PimentoFr/plant-monitor/hardware/schema/plant_monitor.pdf

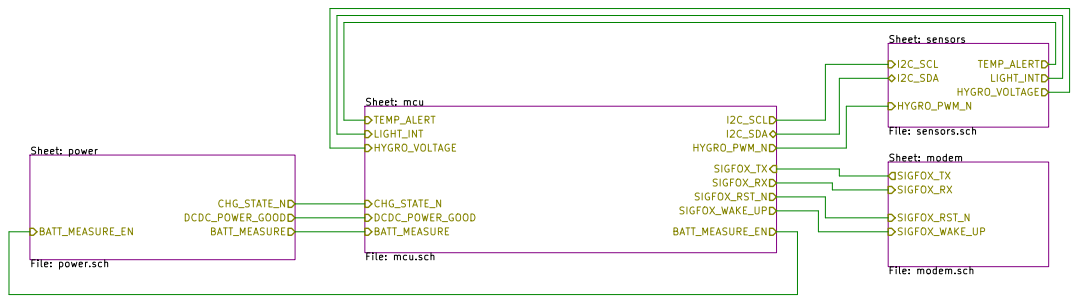
[picture p1: page 1]

Sheet: sensors File: sensors.sch

Sheet: mcu File: mcu.sch
TEMP_ALERT

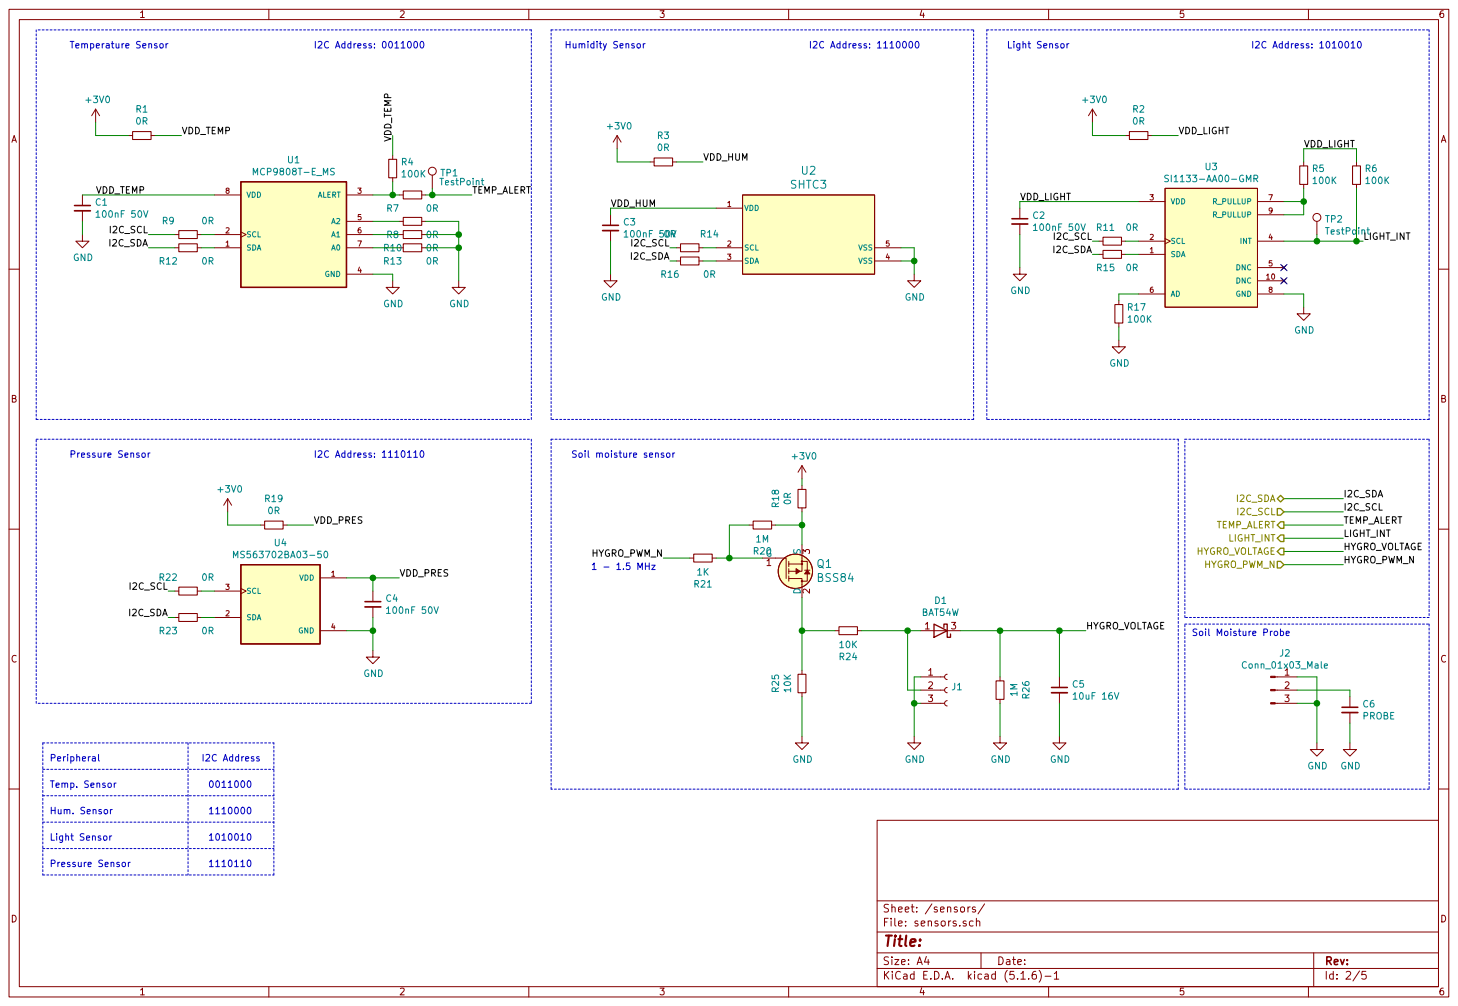
[picture p2: page 2]

Id: 2/5 Title: File: sensors.sch Sheet: /sensors/

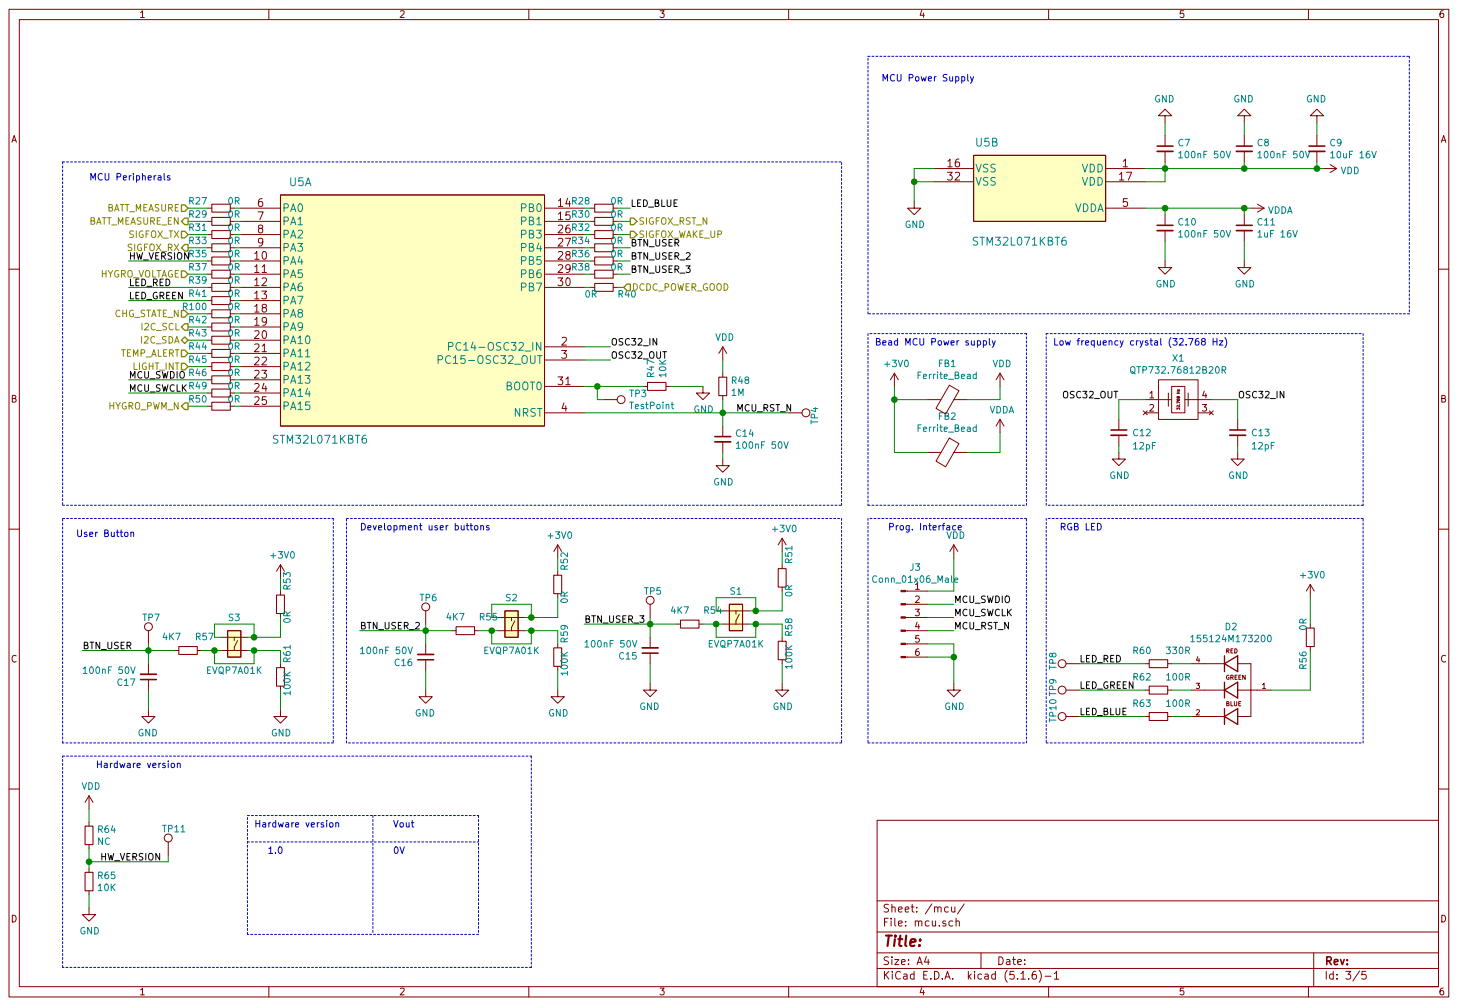
[picture p3: page 3]

Bead MCU Power supply

Low frequency crystal (32.768 Hz) RGB LED

Id: 3/5 Title: File: mcu.sch Sheet: /mcu/ R53 0R GND

Vout

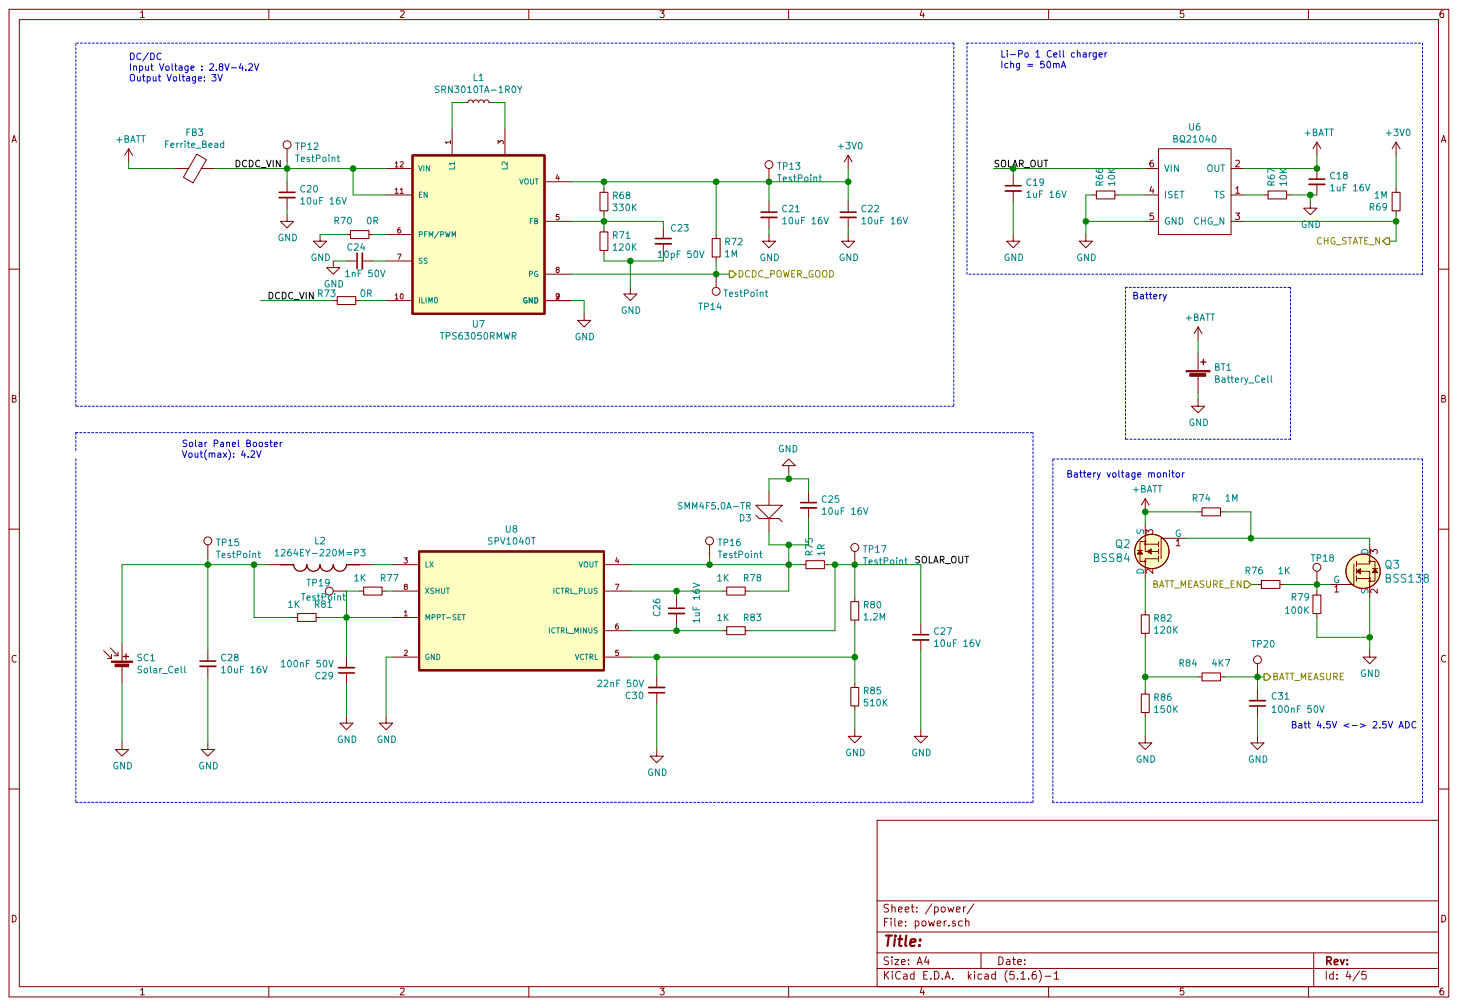
[picture p4: page 4]

3 VOUT 4 FB 5 PFM/PWM 6 SS 7 PG 8 GND 9 U7 TPS63050RMWR

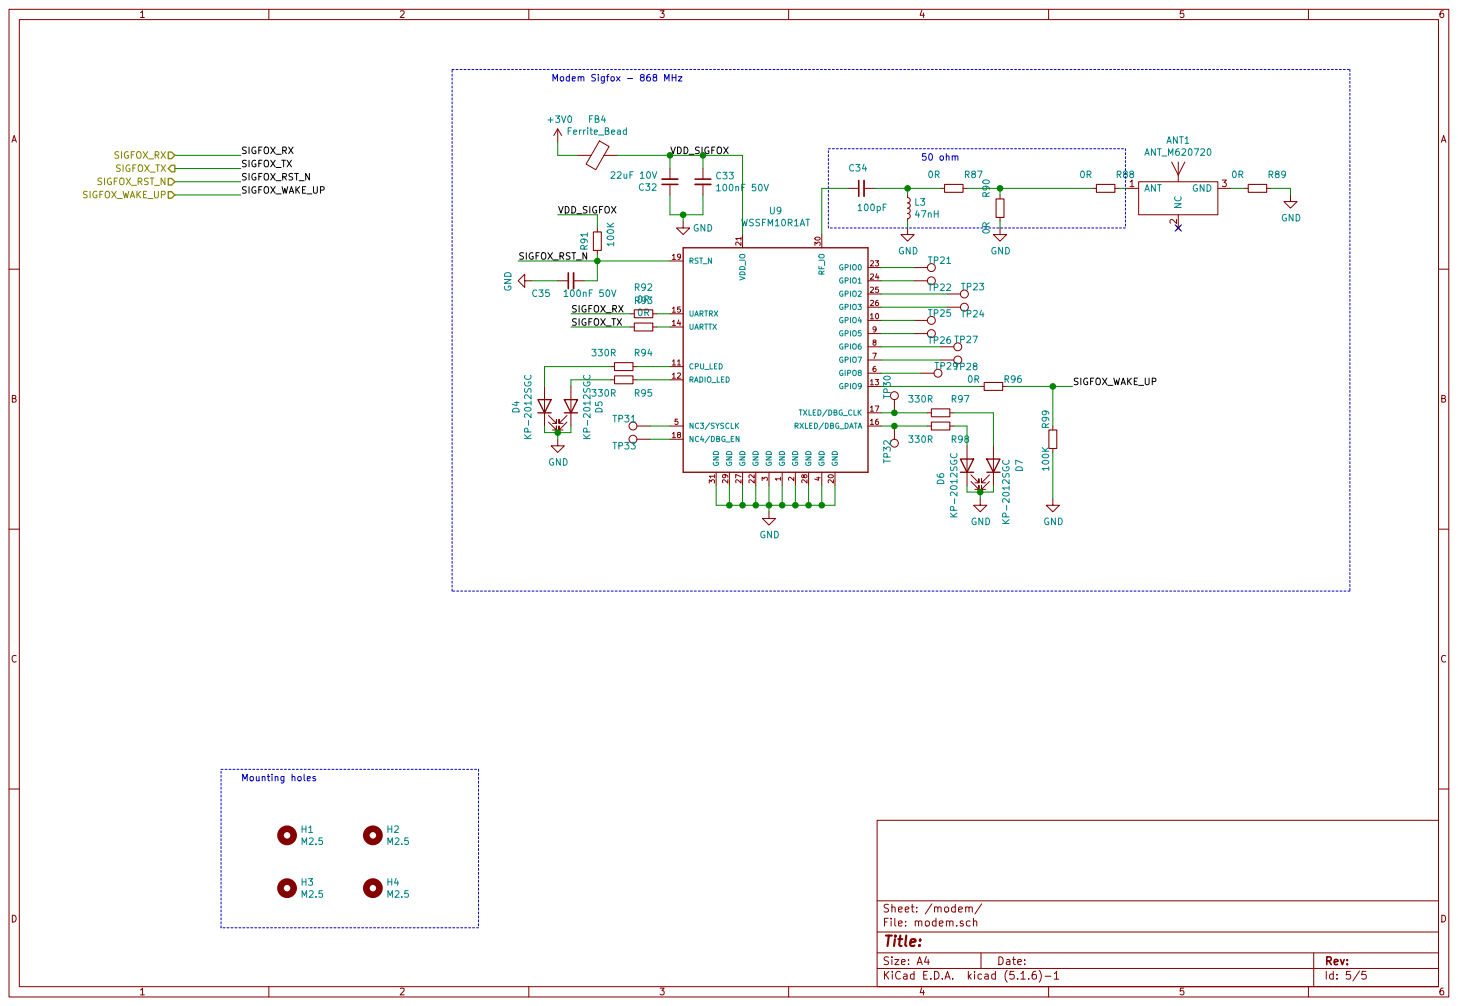
[picture p5: page 5]

2 GND 20 VDD_IO 21 GND 22 GPIO0 23 GPIO1 24 GPIO2 25 GPIO3 26 GND 27 GND 28 GND 29 GND

1 GPIO4 10 CPU_LED 11 RADIO_LED 12 GPIO9 13 UARTTX 14 UARTRX 15 RXLED/DBG_DATA 16 TXLED/DBG_CLK 17 NC4/DBG_EN 18 RST_N 19 GND

Id: 5/5 Title: File: modem.sch Sheet: /modem/
