PimentoFr/plant-monitor/hardware/mainboard/plant_monitor.kicad_pcb

## KiCad design hardware/mainboard/plant_monitor.kicad_pcb (2021-02-21)

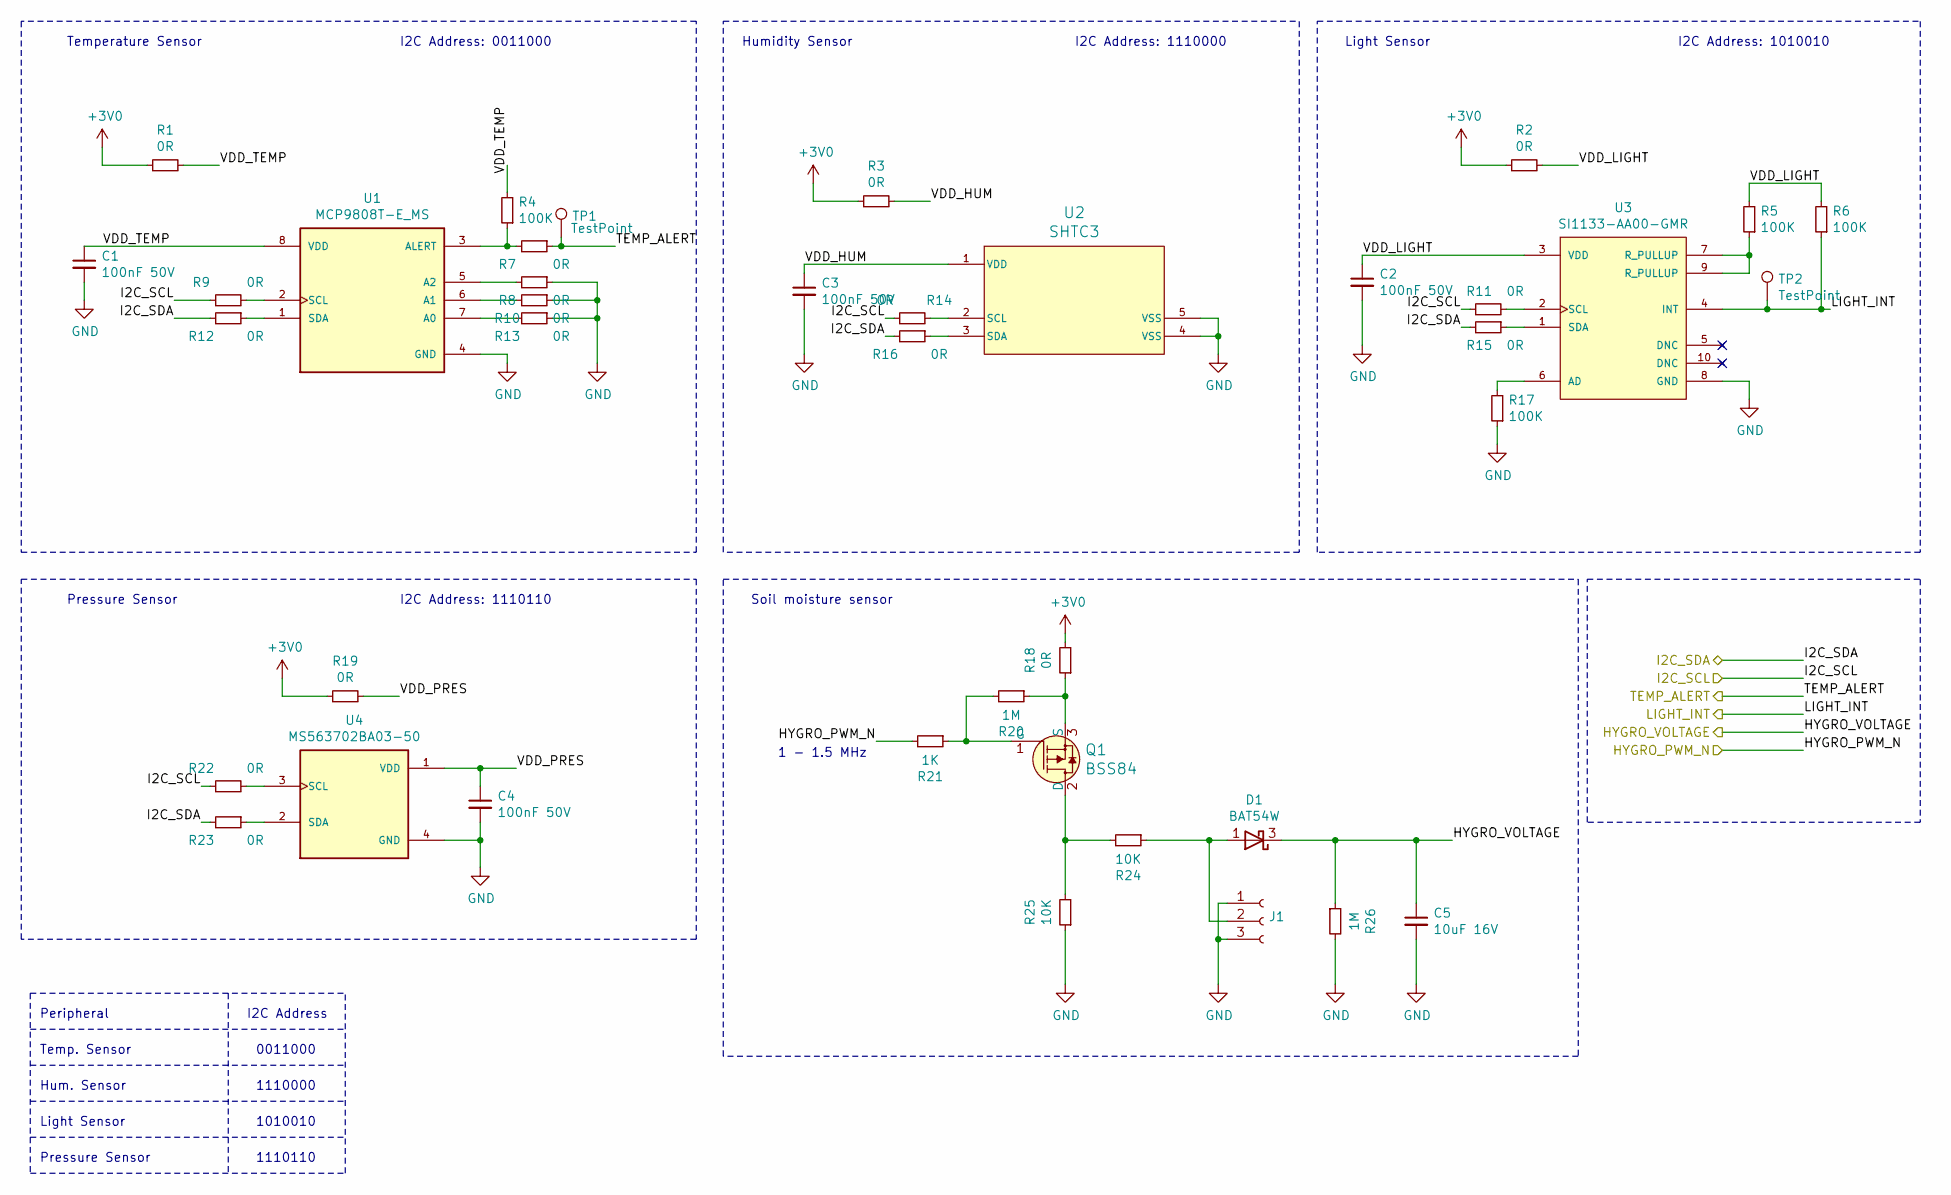
[picture p11: schematic sensors.sch]

Parts:
C1, C2, C3, C4: 100nF 50V; C_0402_1005Metric
C5: 10uF 16V; C_0805_2012Metric_Pad1.15x1.40mm_HandSolder; farnell 3013487
D1: BAT54W; SOT-323_SC-70; farnell 1081197
J1: Conn_01x03_Female; PinSocket_1x03_P2.54mm_Vertical
Q1: BSS84; SOT-23-3; MPN BSS84; Digi-Key_PN BSS84CT-ND
R1, R2, R3, R7, R8, R9, R10, R11, R12, R13, R14, R15, R16, R18, R19, R22, R23: 0R; R_0402_1005Metric
R4, R5, R6, R17: 100K; R_0402_1005Metric
R20, R26: 1M; R_0402_1005Metric
R21: 1K; R_0402_1005Metric
R24, R25: 10K; R_0402_1005Metric
TP1, TP2: TestPoint; TestPoint_Pad_D1.0mm
U1: MCP9808T-E_MS; SOP65P490X110-8N; farnell 2851677
U2: SHTC3; farnell 3106918
U3: SI1133-AA00-GMR; farnell 3105966
U4: MS563702BA03-50; TE_MS563702BA03-50; farnell 2362663

Connections:
+3V0: R1.1, R2.1, R3.1, R18.2, R19.1; also elsewhere on the board
/mcu/HYGRO_PWM_N: R21.2; also elsewhere on the board
/mcu/HYGRO_VOLTAGE: C5.1, D1.3 (K), R26.1; also elsewhere on the board
/mcu/I2C_SCL: R9.1, R11.1, R14.1, R22.1; also elsewhere on the board
/mcu/I2C_SDA: R12.2, R15.2, R16.2, R23.2; also elsewhere on the board
/mcu/LIGHT_INT: R6.1, TP2.1, U3.4 (INT); also elsewhere on the board
/mcu/TEMP_ALERT: R7.1, TP1.1; also elsewhere on the board
/sensors/VDD_HUM: C3.1, R3.2, U2.1 (VDD)
/sensors/VDD_LIGHT: C2.1, R2.2, R5.2, R6.2, U3.3 (VDD)
/sensors/VDD_PRES: C4.1, R19.2, U4.1 (VDD)
/sensors/VDD_TEMP: C1.1, R1.2, R4.2, U1.8 (VDD)
GND: C1.2, C2.2, C3.2, C4.2, C5.2, J1.1, J1.3, R8.1, R10.1, R13.1, R17.1, R25.1, R26.2, U1.4 (GND), U2.4 (VSS), U2.5 (VSS), U3.8 (GND), U4.4 (GND); also elsewhere on the board
unnamed: D1.1 (A), J1.2, R24.1
unnamed: Q1.1 (G), R20.2, R21.1
unnamed: Q1.2 (D), R24.2, R25.2
unnamed: Q1.3 (S), R18.1, R20.1
unnamed: R4.1, R7.2, U1.3 (ALERT)
unnamed: R5.1, U3.7 (R_PULLUP), U3.9 (R_PULLUP)
unnamed: R8.2, U1.5 (A2)
unnamed: R9.2, U1.2 (SCL)
unnamed: R10.2, U1.6 (A1)
unnamed: R11.2, U3.2 (SCL)
unnamed: R12.1, U1.1 (SDA)
unnamed: R13.2, U1.7 (A0)
unnamed: R14.2, U2.2 (SCL)
unnamed: R15.1, U3.1 (SDA)
unnamed: R16.1, U2.3 (SDA)
unnamed: R17.2, U3.6 (AD)
unnamed: R22.2, U4.3 (SCL)
unnamed: R23.1, U4.2 (SDA)

Notes on the sheet:
Temperature Sensor
I2C Address: 0011000
I2C Address
Peripheral
Temp. Sensor
0011000
Humidity Sensor
I2C Address: 1110000
Hum. Sensor
1110000
Light Sensor
I2C Address: 1010010
1010010
Pressure Sensor
I2C Address: 1110110
1110110
Soil moisture sensor
1 - 1.5 MHz

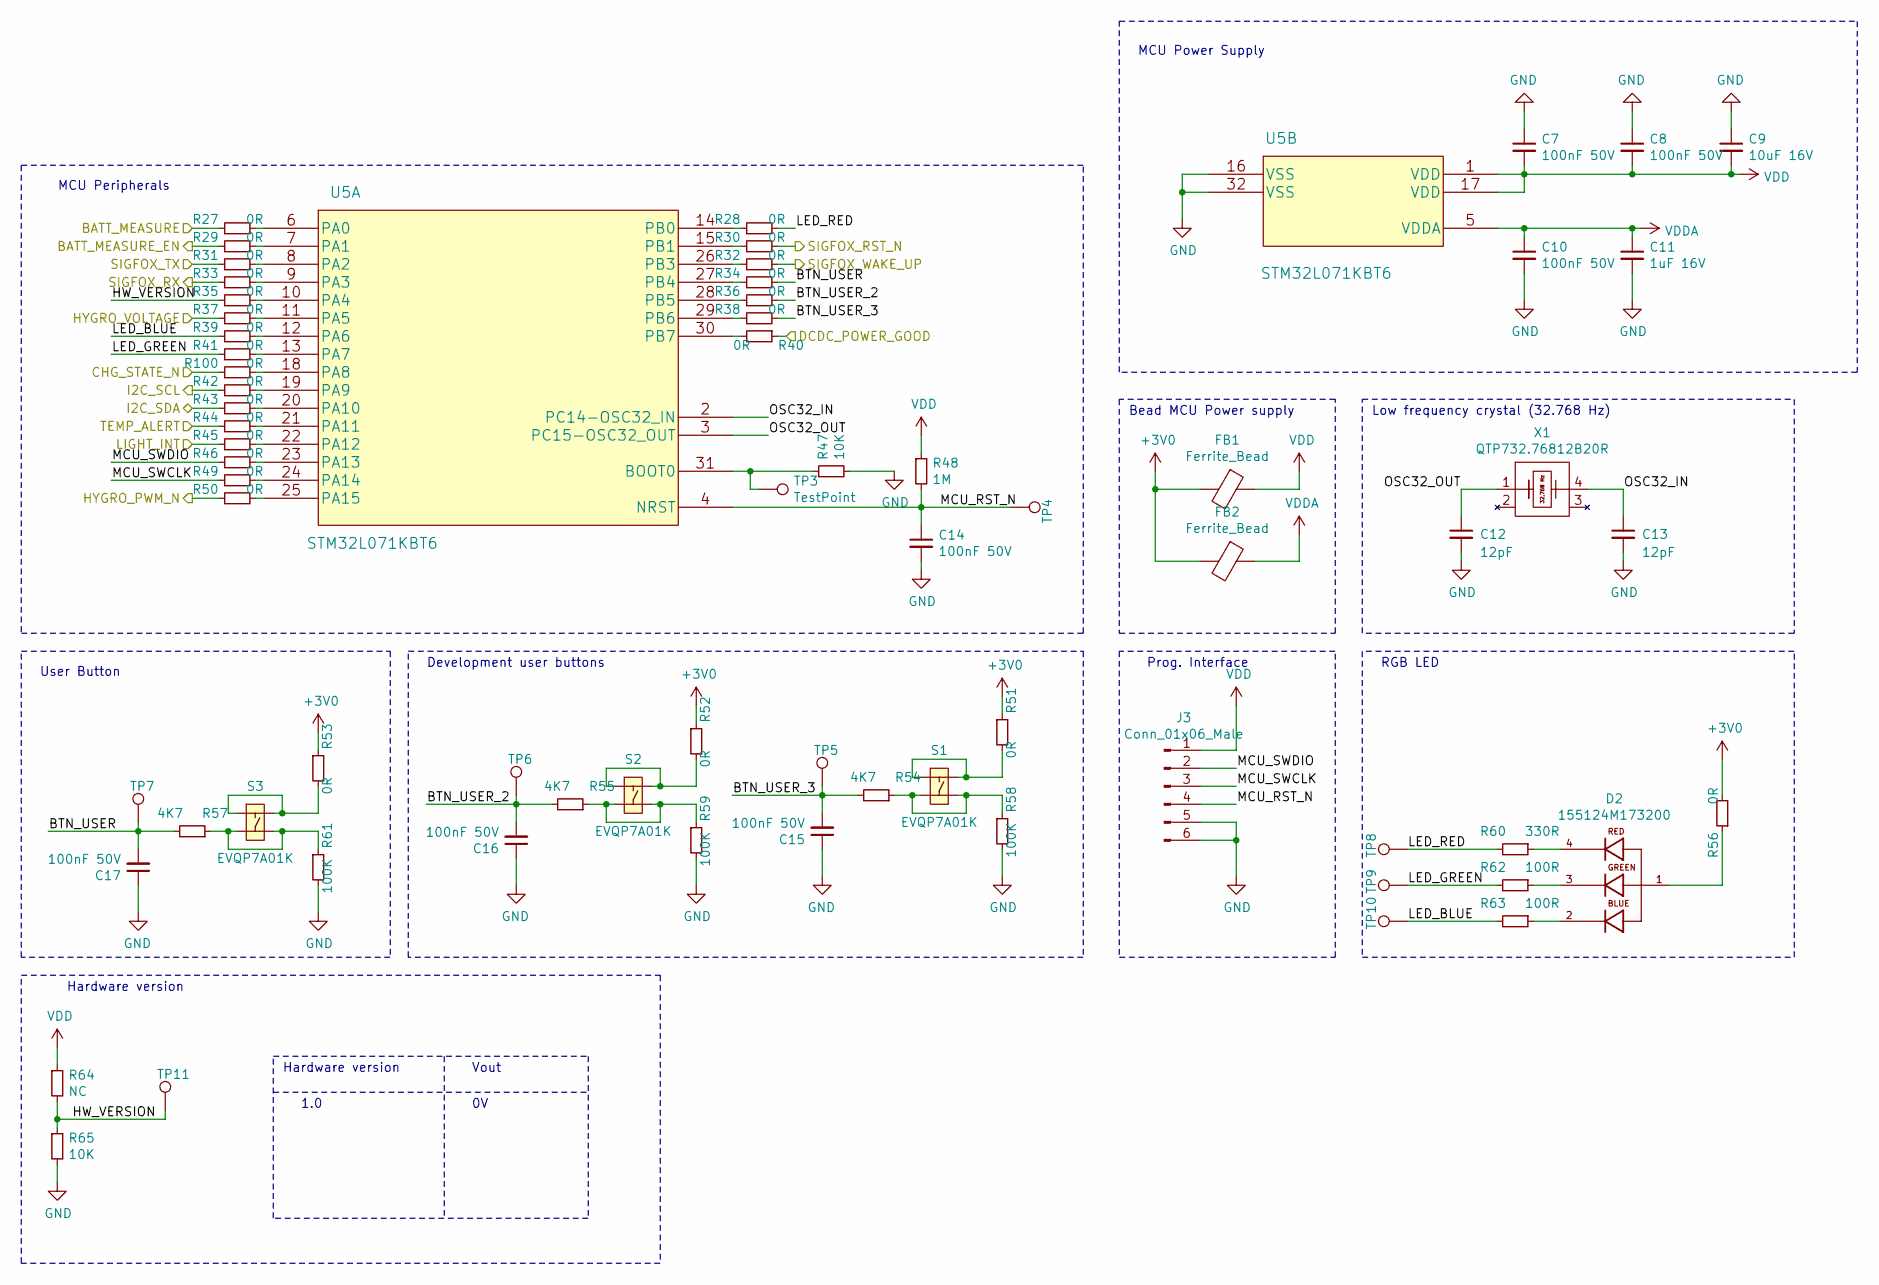
[picture p12: schematic mcu.sch]

Parts:
C7, C8, C10, C14, C15, C16, C17: 100nF 50V; C_0402_1005Metric
C9: 10uF 16V; C_0805_2012Metric_Pad1.15x1.40mm_HandSolder; farnell 3013487
C11: 1uF 16V; C_0603_1608Metric; farnell 3013385
C12, C13: 12pF; C_0402_1005Metric
D2: 155124M173200; LED_155124M173200; PARTREV 001.000; farnell 2764995
FB1, FB2: Ferrite_Bead; R_0402_1005Metric
J3: Conn_01x06_Male; PinHeader_1x06_P2.54mm_Vertical; farnell 1593415
R27, R28, R29, R30, R31, R32, R33, R34, R35, R36, R37, R38, R39, R40, R41, R42, R43, R44, R45, R46, R49, R50, R51, R52, R53, R56, R100: 0R; R_0402_1005Metric
R47, R65: 10K; R_0402_1005Metric
R48: 1M; R_0402_1005Metric
R54, R55, R57: 4K7; R_0402_1005Metric
R58, R59, R61: 100K; R_0402_1005Metric
R60: 330R; R_0402_1005Metric
R62, R63: 100R; R_0402_1005Metric
R64: NC; R_0402_1005Metric
S1, S2, S3: EVQP7A01K; farnell 2079538
TP3, TP4, TP5, TP6, TP7, TP8, TP9, TP10, TP11: TestPoint; TestPoint_Pad_D1.0mm
U5: STM32L071KBT6; farnell 3365397
X1: QTP732.76812B20R; farnell 2508436

Connections:
+3V0: FB1.2, FB2.2, R51.1, R52.1, R53.1, R56.2; also elsewhere on the board
/mcu/BATT_MEASURE: R27.1; also elsewhere on the board
/mcu/BATT_MEASURE_EN: R29.1; also elsewhere on the board
/mcu/BTN_USER: C17.2, R34.2, R57.2, TP7.1
/mcu/BTN_USER_2: C16.2, R36.2, R55.2, TP6.1
/mcu/BTN_USER_3: C15.2, R38.2, R54.2, TP5.1
/mcu/CHG_STATE_N: R100.1; also elsewhere on the board
/mcu/DCDC_POWER_GOOD: R40.1; also elsewhere on the board
/mcu/HW_VERSION: R35.1, R64.2, R65.1, TP11.1
/mcu/HYGRO_PWM_N: R50.1; also elsewhere on the board
/mcu/HYGRO_VOLTAGE: R37.1; also elsewhere on the board
/mcu/I2C_SCL: R42.1; also elsewhere on the board
/mcu/I2C_SDA: R43.1; also elsewhere on the board
/mcu/LED_BLUE: R39.1, R63.2, TP10.1
/mcu/LED_GREEN: R41.1, R62.2, TP9.1
/mcu/LED_RED: R28.2, R60.2, TP8.1
/mcu/LIGHT_INT: R45.1; also elsewhere on the board
/mcu/MCU_RST_N: C14.1, J3.4, R48.2, TP4.1, U5.4 (NRST)
/mcu/MCU_SWCLK: J3.3, R49.1
/mcu/MCU_SWDIO: J3.2, R46.1
/mcu/OSC32_IN: C13.1, U5.2 (PC14-OSC32_IN), X1.4
/mcu/OSC32_OUT: C12.1, U5.3 (PC15-OSC32_OUT), X1.1
/mcu/SIGFOX_RST_N: R30.2; also elsewhere on the board
/mcu/SIGFOX_RX: R33.1; also elsewhere on the board
/mcu/SIGFOX_TX: R31.1; also elsewhere on the board
/mcu/SIGFOX_WAKE_UP: R32.2; also elsewhere on the board
/mcu/TEMP_ALERT: R44.1; also elsewhere on the board
GND: C7.1, C8.1, C9.1, C10.2, C11.2, C12.2, C13.2, C14.2, C15.1, C16.1, C17.1, J3.5, J3.6, R47.2, R58.2, R59.2, R61.2, R65.2, U5.16 (VSS), U5.32 (VSS); also elsewhere on the board
unnamed: D2.1, R56.1
unnamed: D2.2, R63.1
unnamed: D2.3, R62.1
unnamed: D2.4, R60.1
unnamed: R27.2, U5.6 (PA0)
unnamed: R28.1, U5.14 (PB0)
unnamed: R29.2, U5.7 (PA1)
unnamed: R30.1, U5.15 (PB1)
unnamed: R31.2, U5.8 (PA2)
unnamed: R32.1, U5.26 (PB3)
unnamed: R33.2, U5.9 (PA3)
unnamed: R34.1, U5.27 (PB4)
unnamed: R35.2, U5.10 (PA4)
unnamed: R36.1, U5.28 (PB5)
unnamed: R37.2, U5.11 (PA5)
unnamed: R38.1, U5.29 (PB6)
unnamed: R39.2, U5.12 (PA6)
unnamed: R40.2, U5.30 (PB7)
unnamed: R41.2, U5.13 (PA7)
unnamed: R42.2, U5.19 (PA9)
unnamed: R43.2, U5.20 (PA10)
unnamed: R44.2, U5.21 (PA11)
unnamed: R45.2, U5.22 (PA12)
unnamed: R46.2, U5.23 (PA13)
unnamed: R47.1, TP3.1, U5.31 (BOOT0)
unnamed: R49.2, U5.24 (PA14)
unnamed: R50.2, U5.25 (PA15)
unnamed: R51.2, S1.1, S1.4
unnamed: R52.2, S2.1, S2.4
unnamed: R53.2, S3.1, S3.4
unnamed: R54.1, R58.1, S1.2, S1.3
unnamed: R55.1, R59.1, S2.2, S2.3
unnamed: R57.1, R61.1, S3.2, S3.3
unnamed: R100.2, U5.18 (PA8)
VDD: C7.2, C8.2, C9.2, FB1.1, J3.1, R48.1, R64.1, U5.1 (VDD), U5.17 (VDD)
VDDA: C10.1, C11.1, FB2.1, U5.5 (VDDA)

Notes on the sheet:
Hardware version
Vout
1.0
RGB LED
Low frequency crystal (32.768 Hz)
User Button
Development user buttons
MCU Peripherals
MCU Power Supply
Prog. Interface
Bead MCU Power supply

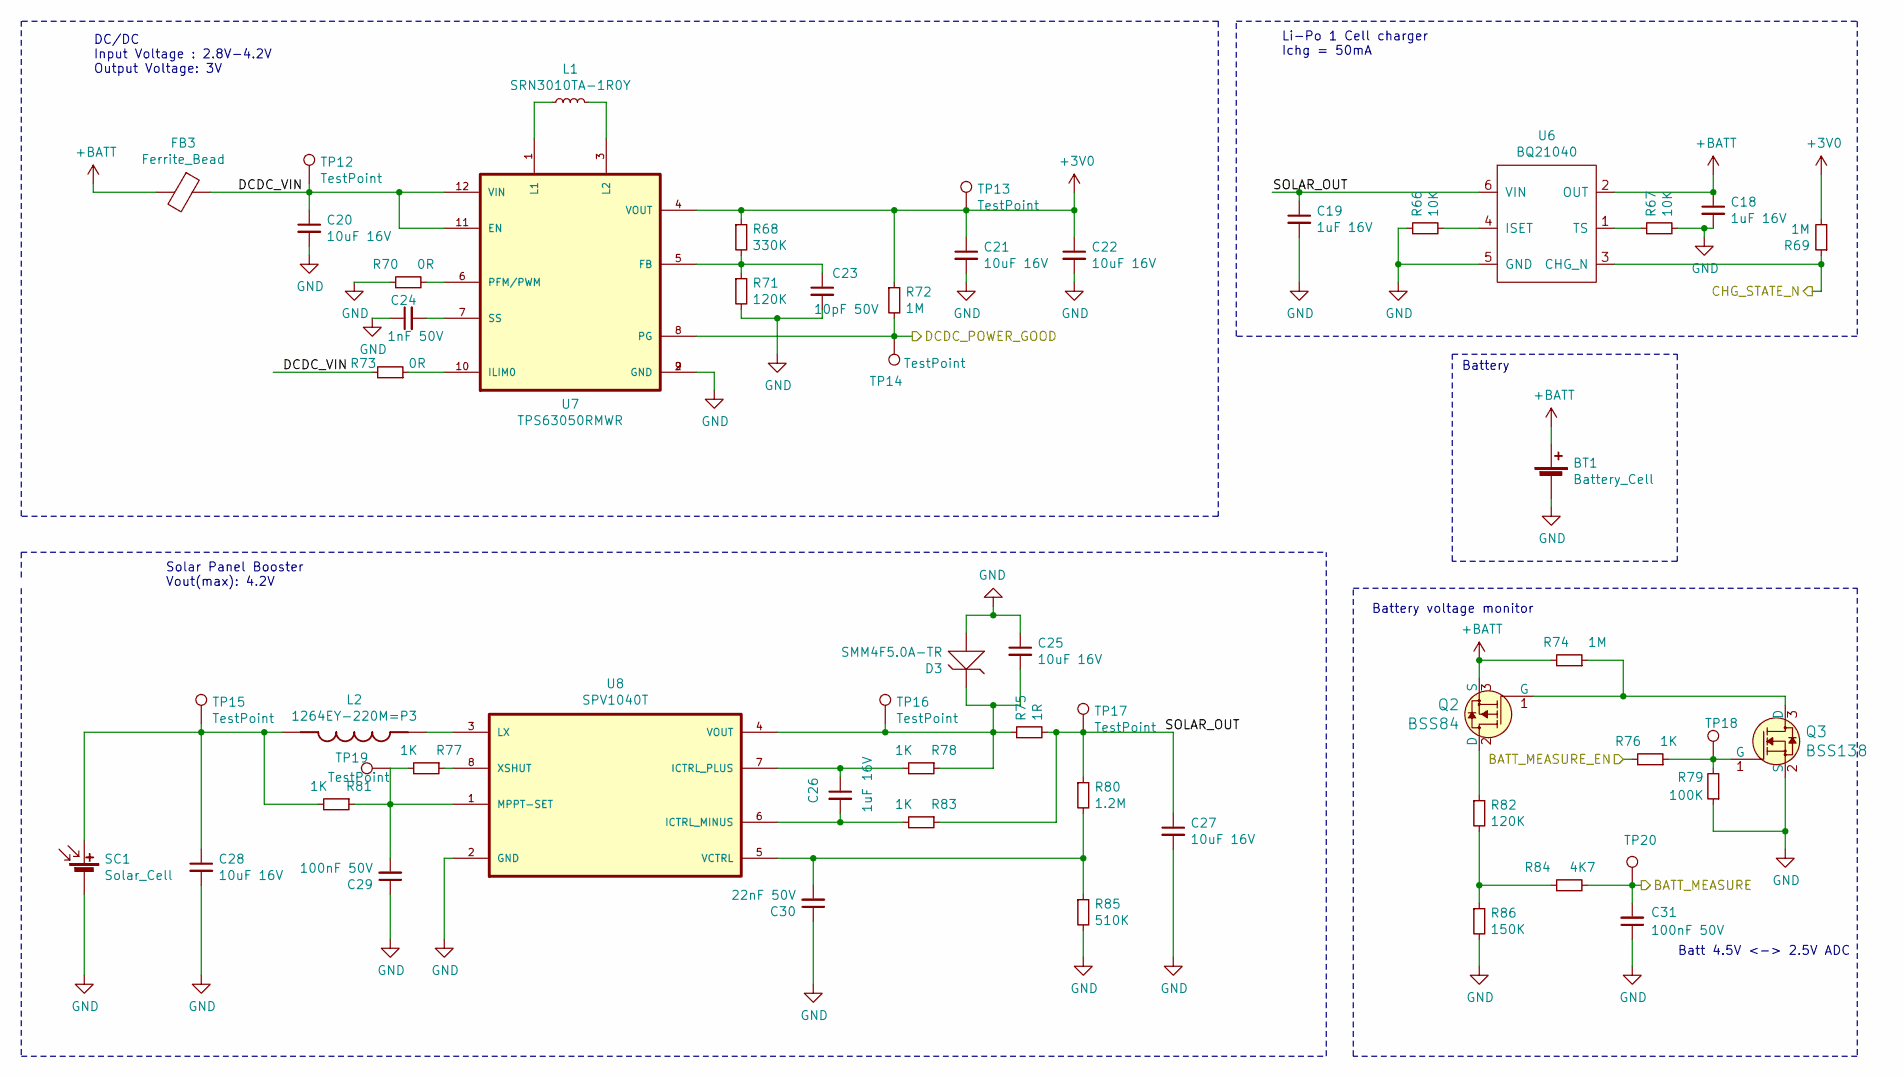
[picture p13: schematic power.sch]

Parts:
BT1: Battery_Cell; JST_PH_S2B-PH-K_1x02_P2.00mm_Horizontal
C18, C19, C26: 1uF 16V; C_0603_1608Metric; farnell 3013385
C20, C21, C22, C25, C27, C28: 10uF 16V; C_0805_2012Metric_Pad1.15x1.40mm_HandSolder; farnell 3013487
C23: 10pF 50V; C_0402_1005Metric
C24: 1nF 50V; C_0402_1005Metric
C29, C31: 100nF 50V; C_0402_1005Metric
C30: 22nF 50V; C_0402_1005Metric
D3: SMM4F5.0A-TR; farnell 1689313
FB3: Ferrite_Bead; R_0402_1005Metric
L1: SRN3010TA-1R0Y; SRN3010TA; farnell 2808286
L2: 1264EY-220M=P3; IND_1264EY-220M=P3; PARTREV N/A; farnell 2871571
Q2: BSS84; SOT-23-3; MPN BSS84; Digi-Key_PN BSS84CT-ND
Q3: BSS138; SOT-23-3; MPN BSS138; Digi-Key_PN BSS138CT-ND
R66, R67: 10K; R_0402_1005Metric
R68: 330K; R_0402_1005Metric
R69, R72, R74: 1M; R_0402_1005Metric
R70, R73: 0R; R_0402_1005Metric
R71, R82: 120K; R_0402_1005Metric
R75: 1R; R_0402_1005Metric
R76, R77, R78, R81, R83: 1K; R_0402_1005Metric
R79: 100K; R_0402_1005Metric
R80: 1.2M; R_0402_1005Metric
R84: 4K7; R_0402_1005Metric
R85: 510K; R_0402_1005Metric
R86: 150K; R_0402_1005Metric
SC1: Solar_Cell; SOLAR_CELL
TP12, TP13, TP14, TP15, TP16, TP17, TP18, TP19, TP20: TestPoint; TestPoint_Pad_D1.0mm
U6: BQ21040; SOT-23-6
U7: TPS63050RMWR; QFN50P250X250X100-12N; farnell 3007462
U8: SPV1040T; SOP65P640X120-8N; PARTREV 7; farnell 2762710

Connections:
+3V0: C21.1, C22.1, R68.1, R69.2, R72.1, TP13.1, U7.4 (VOUT); also elsewhere on the board
+BATT: BT1.1 (+), C18.1, FB3.2, Q2.3 (S), R74.2, U6.2 (OUT)
/mcu/BATT_MEASURE: C31.2, R84.2, TP20.1; also elsewhere on the board
/mcu/BATT_MEASURE_EN: R76.2; also elsewhere on the board
/mcu/CHG_STATE_N: R69.1, U6.3 (CHG_N); also elsewhere on the board
/mcu/DCDC_POWER_GOOD: R72.2, TP14.1, U7.8 (PG); also elsewhere on the board
/power/DCDC_VIN: C20.1, FB3.1, R73.2, TP12.1, U7.11 (EN), U7.12 (VIN)
/power/SOLAR_OUT: C19.1, C27.1, R75.2, R80.1, R83.1, TP17.1, U6.6 (VIN)
GND: BT1.2 (-), C18.2, C19.2, C20.2, C21.2, C22.2, C23.2, C24.1, C25.1, C27.2, C28.2, C29.1, C30.1, C31.1, D3.A, Q3.2 (S), R66.1, R67.2, R70.1, R71.2, R79.1, R85.2, R86.2, SC1.2 (-), U6.5 (GND), U7.2 (GND), U7.9 (GND), U8.2 (GND); also elsewhere on the board
unnamed: C23.1, R68.2, R71.1, U7.5 (FB)
unnamed: C24.2, U7.7 (SS)
unnamed: C25.2, D3.K, R75.1, R78.1, TP16.1, U8.4 (VOUT)
unnamed: C26.1, R78.2, U8.7 (ICTRL_PLUS)
unnamed: C26.2, R83.2, U8.6 (ICTRL_MINUS)
unnamed: C28.1, L2.1, R81.2, SC1.1 (+), TP15.1
unnamed: C29.2, R77.2, R81.1, TP19.1, U8.1 (MPPT-SET)
unnamed: C30.2, R80.2, R85.1, U8.5 (VCTRL)
unnamed: L1.1, U7.1 (L1)
unnamed: L1.2, U7.3 (L2)
unnamed: L2.2, U8.3 (LX)
unnamed: Q2.1 (G), Q3.3 (D), R74.1
unnamed: Q2.2 (D), R82.1
unnamed: Q3.1 (G), R76.1, R79.2, TP18.1
unnamed: R66.2, U6.4 (ISET)
unnamed: R67.1, U6.1 (TS)
unnamed: R70.2, U7.6 (PFM/PWM)
unnamed: R73.1, U7.10 (ILIM0)
unnamed: R77.1, U8.8 (XSHUT)
unnamed: R82.2, R84.1, R86.1

Notes on the sheet:
DC/DC Input Voltage : 2.8V-4.2V Output Voltage: 3V
Solar Panel Booster Vout(max): 4.2V
Li-Po 1 Cell charger Ichg = 50mA
Battery
Battery voltage monitor
Batt 4.5V <-> 2.5V ADC

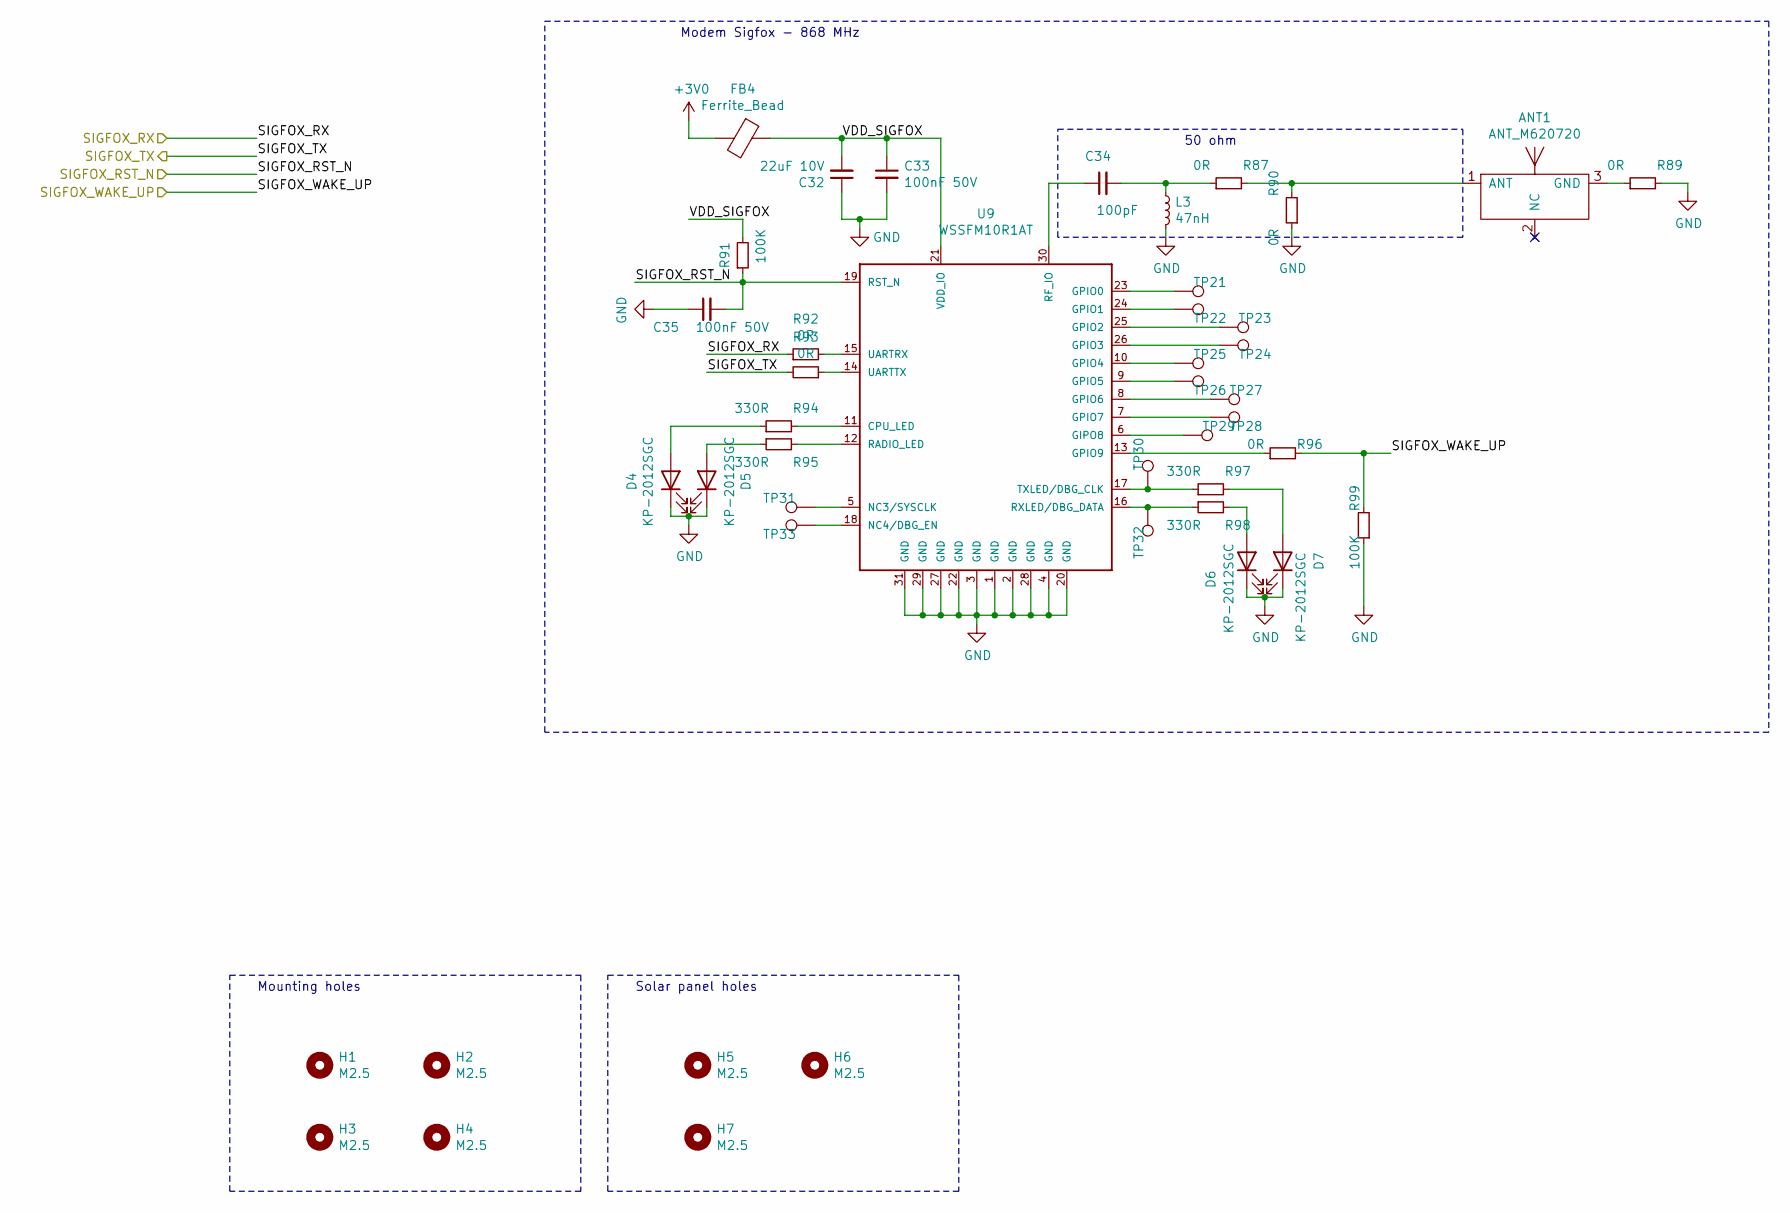
[picture p14: schematic modem.sch]

Parts:
ANT1: ANT_M620720; M620720; digikey 939-1066-1-ND
C32: 22uF 10V; C_0805_2012Metric_Pad1.15x1.40mm_HandSolder; farnell 2494270
C33, C35: 100nF 50V; C_0402_1005Metric
C34: 100pF; C_0402_1005Metric
D4, D5, D6, D7: KP-2012SGC; farnell 1318243
FB4: Ferrite_Bead; R_0402_1005Metric
H1, H2, H3, H4, H5, H6, H7: M2.5; MountingHole_2.7mm_M2.5
L3: 47nH; L_0402_1005Metric
R87, R89, R90, R92, R93, R96: 0R; R_0402_1005Metric
R91, R99: 100K; R_0402_1005Metric
R94, R95, R97, R98: 330R; R_0402_1005Metric
TP21, TP22, TP23, TP24, TP25, TP26, TP27, TP28, TP29, TP30, TP31, TP32, TP33: TestPoint; TestPoint_Pad_D1.0mm
U9: WSSFM10R1AT; XCVR_WSSFM10R1AT_HANDSOLDER

Connections:
+3V0: FB4.2; also elsewhere on the board
/mcu/SIGFOX_RST_N: C35.2, R91.1, U9.19 (RST_N); also elsewhere on the board
/mcu/SIGFOX_RX: R92.1; also elsewhere on the board
/mcu/SIGFOX_TX: R93.2; also elsewhere on the board
/mcu/SIGFOX_WAKE_UP: R96.2, R99.2; also elsewhere on the board
/modem/VDD_SIGFOX: C32.2, C33.1, FB4.1, R91.2, U9.21 (VDD_IO)
GND: C32.1, C33.2, C35.1, D4.1 (K), D5.1 (K), D6.1 (K), D7.1 (K), L3.2, R89.2, R90.1, R99.1, U9.1 (GND), U9.2 (GND), U9.3 (GND), U9.4 (GND), U9.20 (GND), U9.22 (GND), U9.27 (GND), U9.28 (GND), U9.29 (GND), U9.31 (GND); also elsewhere on the board
unnamed: ANT1.1 (ANT), R87.2, R90.2
unnamed: ANT1.3 (GND), R89.1
unnamed: C34.1, U9.30 (RF_IO)
unnamed: C34.2, L3.1, R87.1
unnamed: D4.2 (A), R94.1
unnamed: D5.2 (A), R95.1
unnamed: D6.2 (A), R98.2
unnamed: D7.2 (A), R97.2
unnamed: R92.2, U9.15 (UARTRX)
unnamed: R93.1, U9.14 (UARTTX)
unnamed: R94.2, U9.11 (CPU_LED)
unnamed: R95.2, U9.12 (RADIO_LED)
unnamed: R96.1, U9.13 (GPIO9)
unnamed: R97.1, TP30.1, U9.17 (TXLED/DBG_CLK)
unnamed: R98.1, TP32.1, U9.16 (RXLED/DBG_DATA)
unnamed: TP21.1, U9.23 (GPIO0)
unnamed: TP22.1, U9.24 (GPIO1)
unnamed: TP23.1, U9.25 (GPIO2)
unnamed: TP24.1, U9.26 (GPIO3)
unnamed: TP25.1, U9.10 (GPIO4)
unnamed: TP26.1, U9.9 (GPIO5)
unnamed: TP27.1, U9.8 (GPIO6)
unnamed: TP28.1, U9.7 (GPIO7)
unnamed: TP29.1, U9.6 (GIPO8)
unnamed: TP31.1, U9.5 (NC3/SYSCLK)
unnamed: TP33.1, U9.18 (NC4/DBG_EN)

Notes on the sheet:
Modem Sigfox - 868 MHz
50 ohm
Mounting holes
Solar panel holes

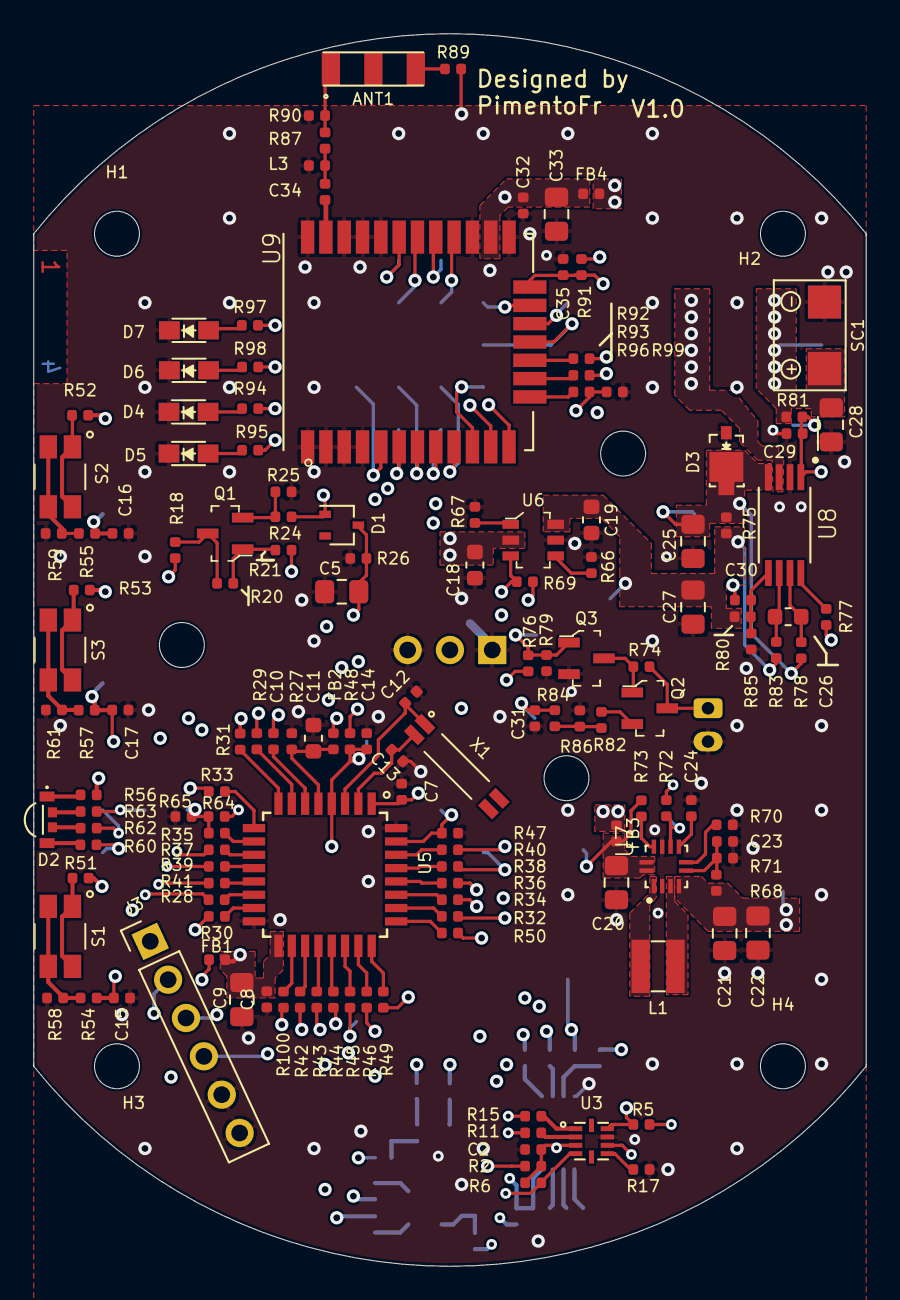
[picture p15: board plant_monitor.kicad_pcb from above]

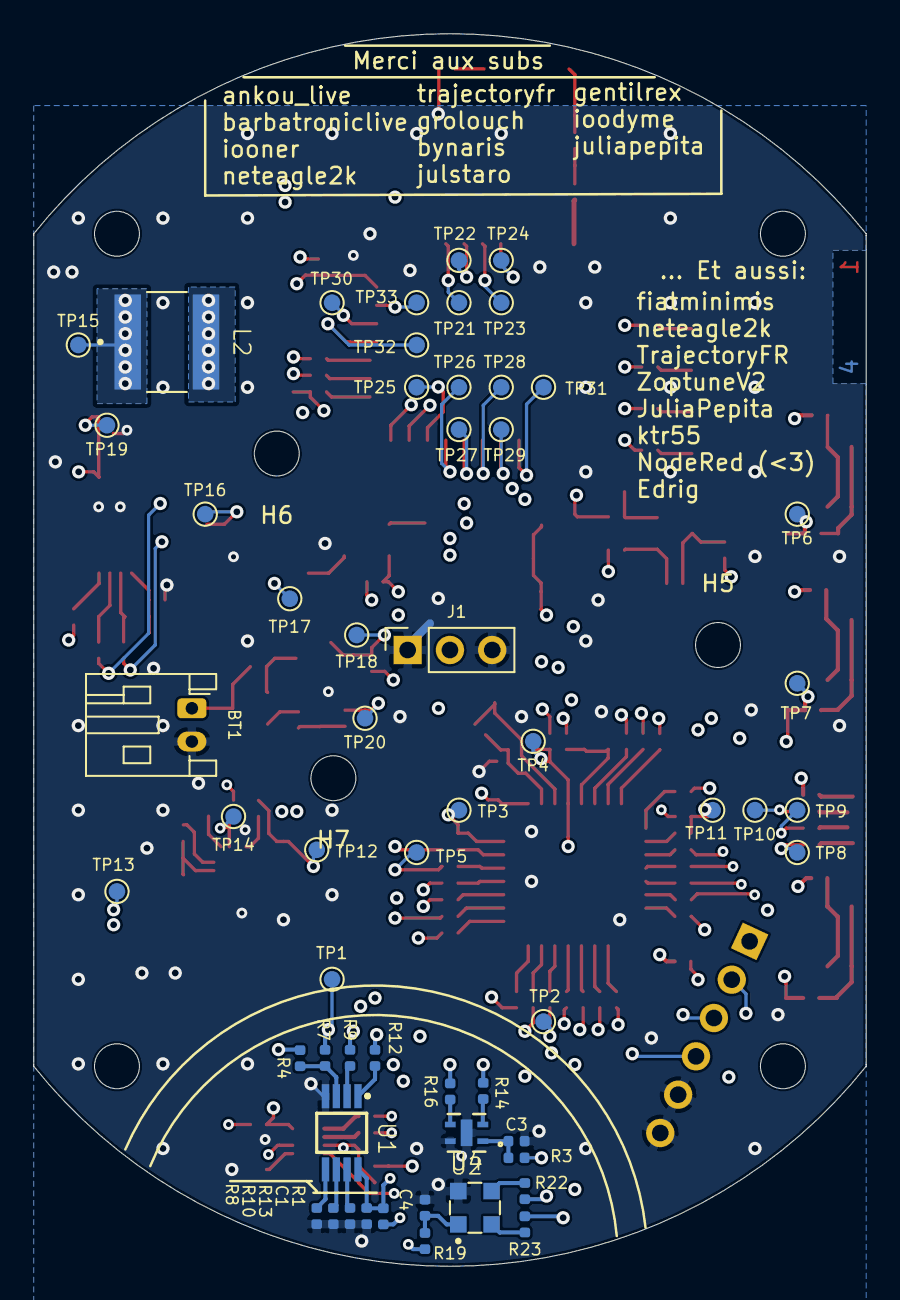
[picture p16: board plant_monitor.kicad_pcb from below]

Board: 4 copper layers, 50.0 x 74.0 mm, 208 parts (58 on the bottom side), 136 nets.
