PimentoFr/plant-monitor/(commit log)

2021-02-06 wip 2
    [modem.sch, plant_monitor.kicad_pcb]
2021-02-21 plant monitor
    [mcu.sch, modem.sch, plant_monitor.kicad_pcb, plant_monitor.sch, plant_monitor_chantier.kicad_pcb, power.sch, sensors.sch]
